Blacksheep909/Juno-1-FPV-Frame/README.md

<h1 align="center">Juno-1</h1>

<p align="center">
  <strong>A one-piece, 3D-printed 2.5" FPV quad frame I designed, analysed and refined before the first print.</strong><br>
  Sculpted tube structure, pusher props, battery underneath, and the stress, vibration and clearance analysis that shaped it.
</p>

<p align="center">
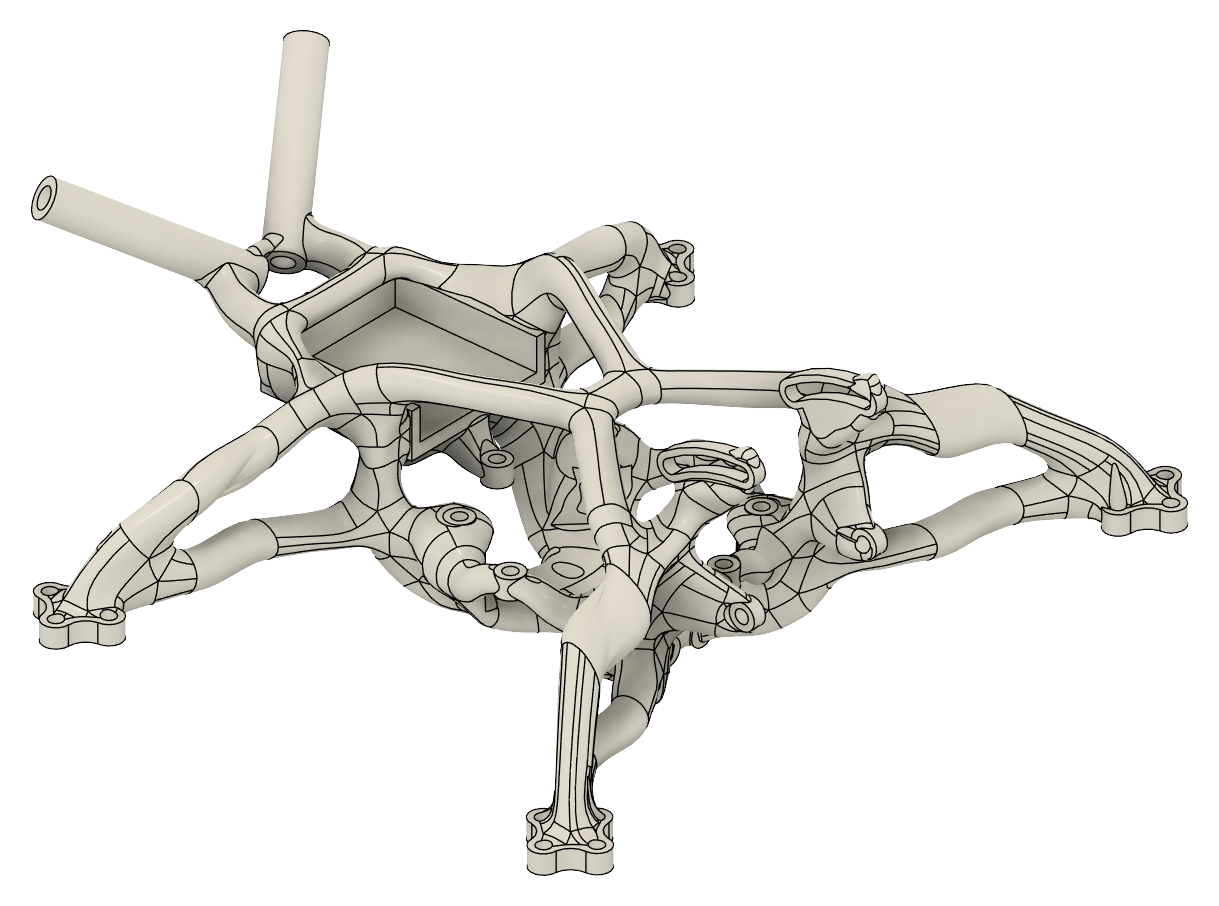
[picture p1: docs/images/cad-hero-iso.png]
Juno-1 Wide frame CAD render: a sculpted one-piece quad frame with twin-strut arms, an X-braced stack cage, a front camera mount and two rear antenna tubes
  
</p>

<p align="center">
  <a href="#the-frame">The frame</a> ·
  <a href="#what-i-designed-and-analysed">What I did</a> ·
  <a href="fea/README.md">FEA write-up</a> ·
  <a href="docs/design-notes.md">Design notes</a> ·
  <a href="stl"><strong>Download the STLs</strong></a>
</p>

<table>
  <tr>
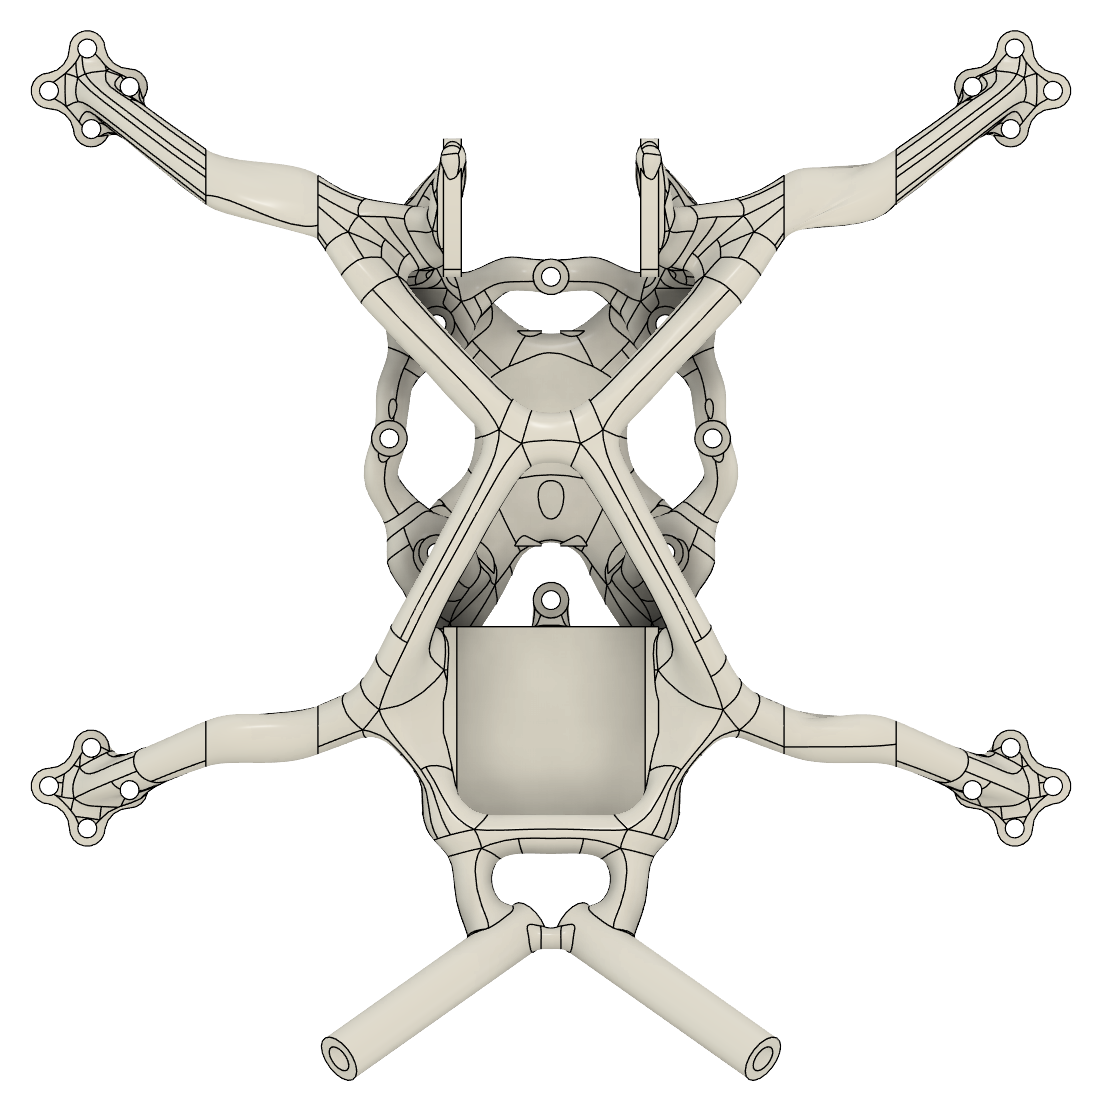
[picture p2: docs/images/cad-top.png]
Juno-1 Wide from above
    <td width="33%"><br><sub><b>Top.</b> X-braced stack cage, camera at the front, antenna tubes at the rear.</sub></td>
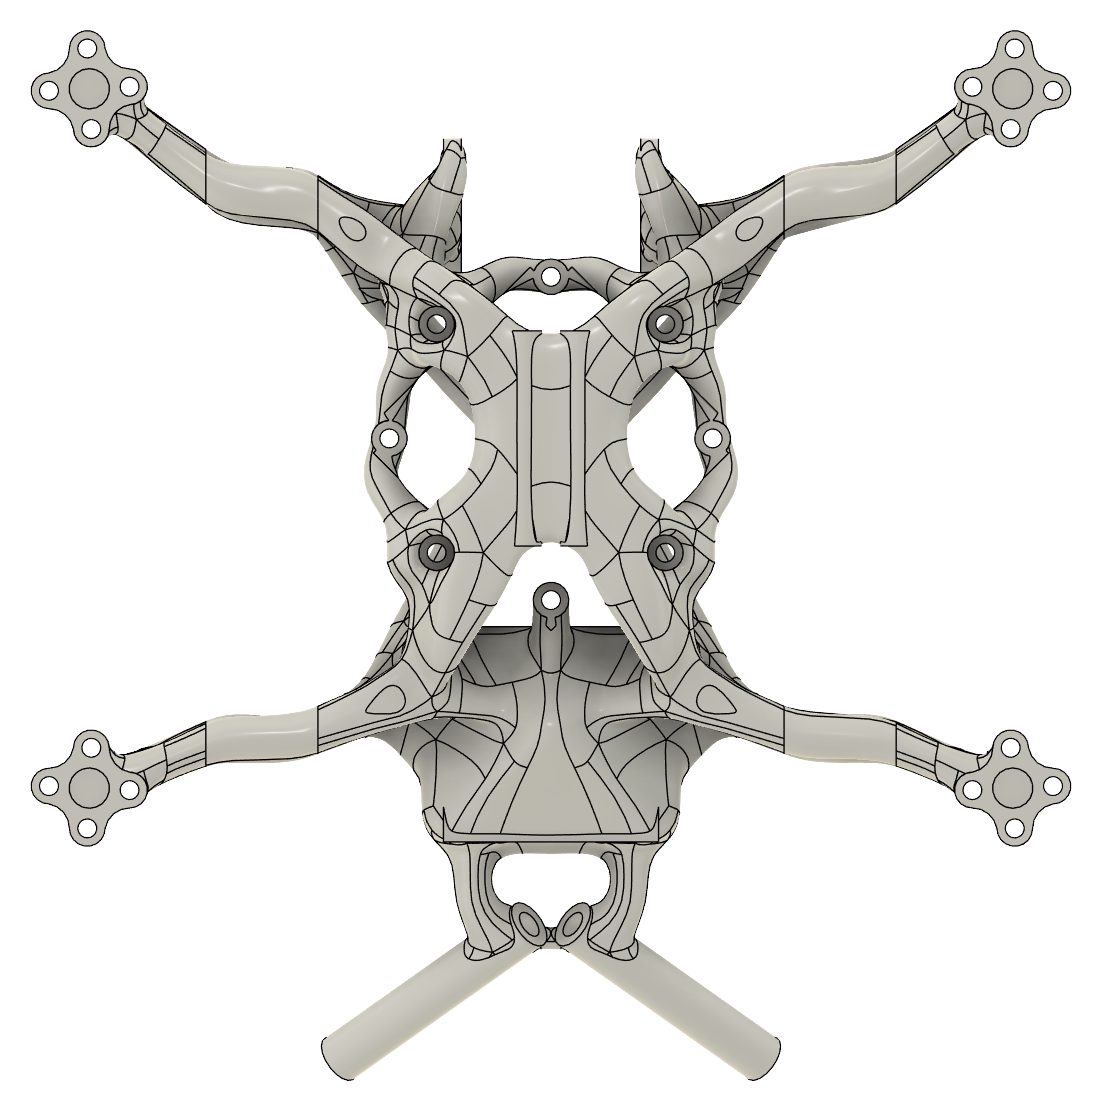
[picture p3: docs/images/cad-bottom.png]
Juno-1 Wide from below showing the battery rails
    <td width="33%"><br><sub><b>Bottom.</b> Battery rails and strap windows; motors bolt under the pads.</sub></td>
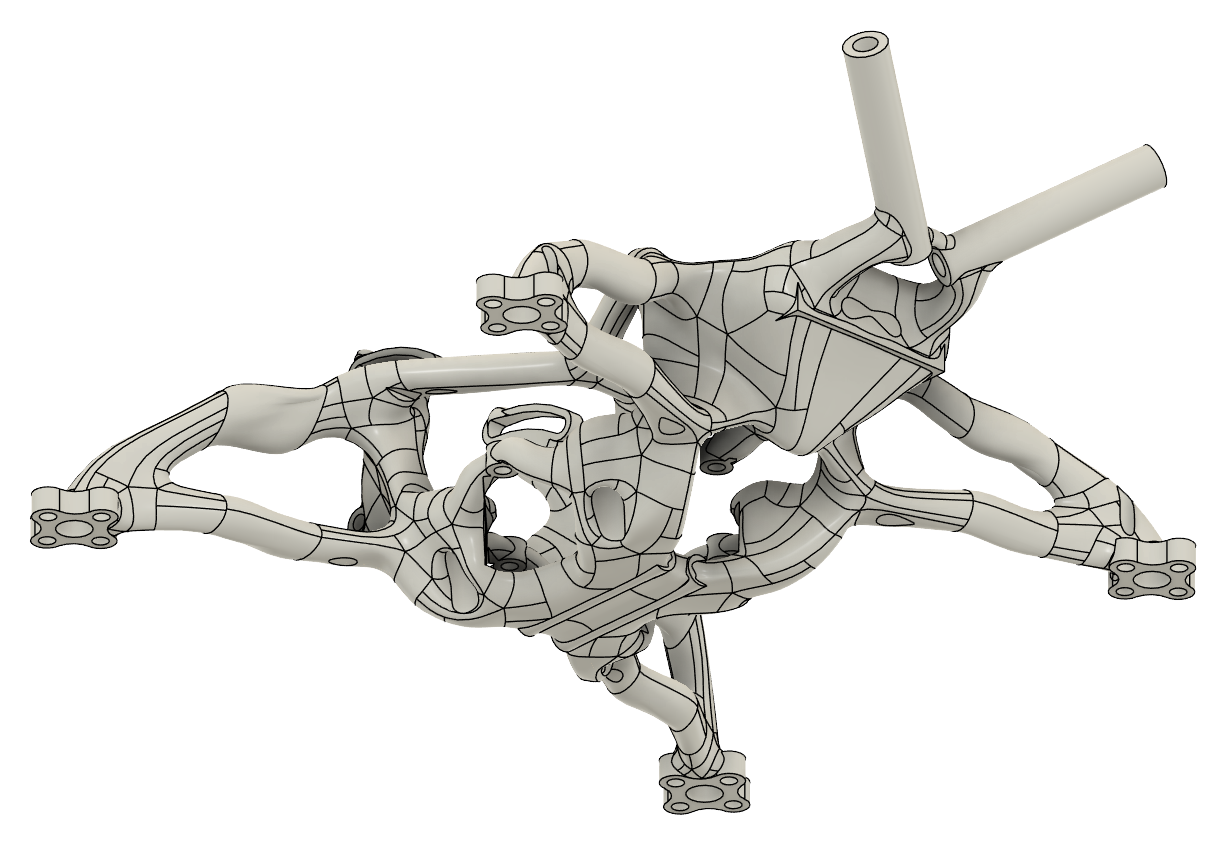
[picture p4: docs/images/cad-rear-iso-below.png]
Juno-1 Wide from the rear and below
    <td width="33%"><br><sub><b>Rear, from below.</b> Twin-strut arms meeting at each motor pad.</sub></td>
  </tr>
</table>

## The frame

Juno-1 is a 2.5" quad frame printed in one piece in PETG. Instead of flat carbon plates, the body and arms are a sculpted tube structure: each arm is a pair of struts that meet at the motor pad, the stack sits in an X-braced cage, the camera hangs off the front and two antenna tubes point back and up. It flies as a **pusher**, with the motors under the pads and the battery strapped under the belly.

This is the first build: the frame is designed, analysed and being printed now. Build photos and flight notes are coming.

| | |
| --- | --- |
| **Size** | 2.5" props, 129 mm wheelbase, 117 × 116 × 44.5 mm overall |
| **Layout** | Pusher: motors and props under the pads |
| **Battery** | 4S, strapped underneath, lying front to back (built around GNB 650 and 850 mAh packs) |
| **Motor mount** | 9 mm M2 pattern, Ø4.5 mm shaft pocket, two screws per motor |
| **Stack** | 25.5 × 25.5 mm whoop-style AIO |
| **Camera** | 19 mm micro camera |
| **Material** | PETG, 4 walls, 20% infill, printed in one piece |
| **CAD** | Fusion, with STEP, F3D and STL files included |

## What I designed and analysed

<p align="center">
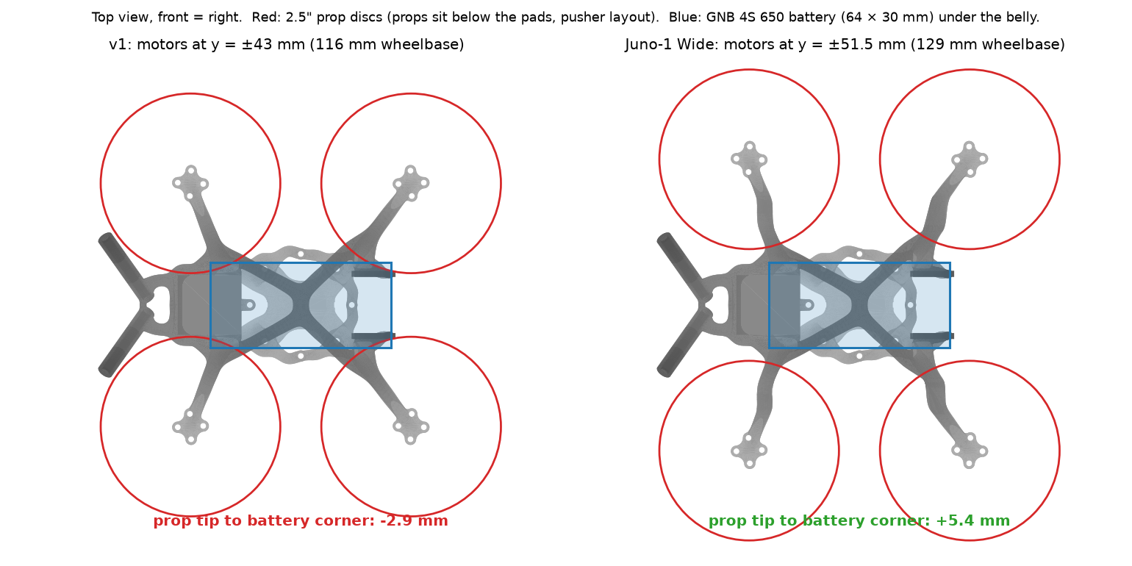
[picture p5: docs/images/layout-v1-vs-wide.png]
Top views of v1 and Juno-1 Wide with prop discs and battery footprint drawn: on v1 the props overlap the battery corners by 2.9 mm, on Juno-1 Wide they clear by 5.4 mm
  
</p>

- **Mechanical design.** A sculpted single-piece frame in Fusion, with twin-strut arms, an X-braced stack cage and built-in camera and antenna mounts. See the [design notes](docs/design-notes.md).
- **Analysis before printing.** I ran the first version (v1) through whole-frame finite-element stress analysis in PETG, with a separate check for stress across the print layers, plus free-free vibration analysis, printability checks and prop and battery clearance checks. See the [FEA write-up](fea/README.md).
- **Design changes driven by the analysis.**
  - In a pusher layout, v1's props reached 3 mm into a bottom-mounted 4S battery, so I moved the motors out to a 129 mm wheelbase. I did it by cutting the arms, moving the outer sections and lofting the eight struts back together with tangent ends.
  - A leftover prop-relief cut had left a sharp 90° notch under every arm root. I removed it.
  - Buried inboard screw holes led to a two-screw motor mount, which suits a pusher layout.
- **Open, reproducible tooling.** The FEA pipeline is plain Python (gmsh, scikit-fem, pyamg), so anyone can re-run it on their own revision. See [re-running](fea/README.md#re-running).

<table>
  <tr>
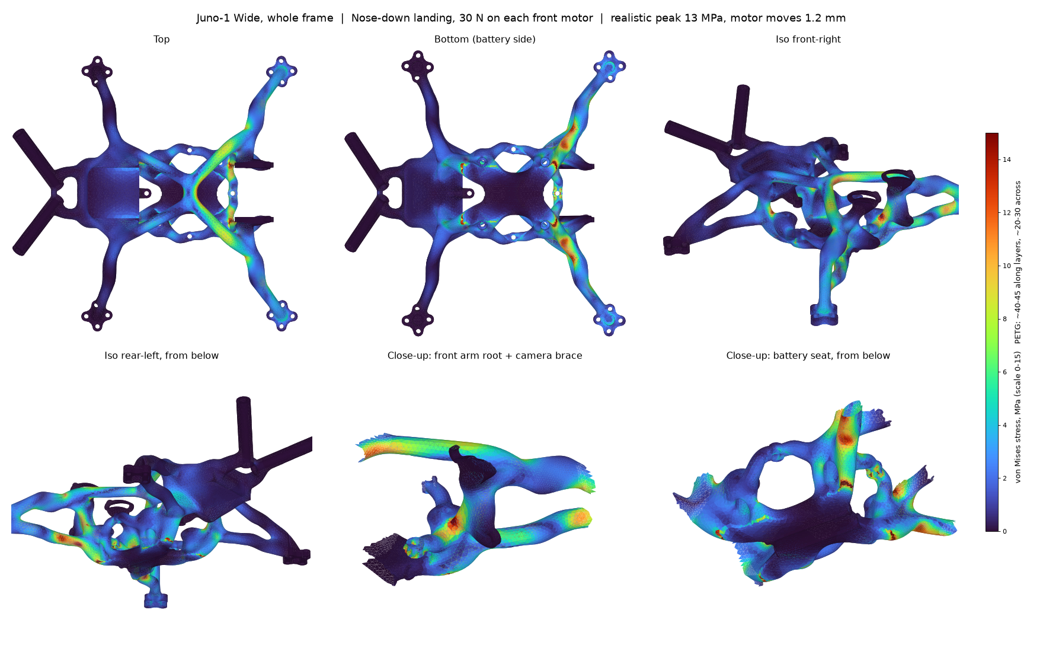
[picture p6: fea/results/images/nose_down.png]
Stress map of the nose-down landing case: the front arms and battery seat corners carry the load
    <td width="50%"><br><sub><b>Worst case: nose-down landing.</b> 30 N on each front motor; about 13 MPa realistic peak, a safety factor of about 3 in-layer.</sub></td>
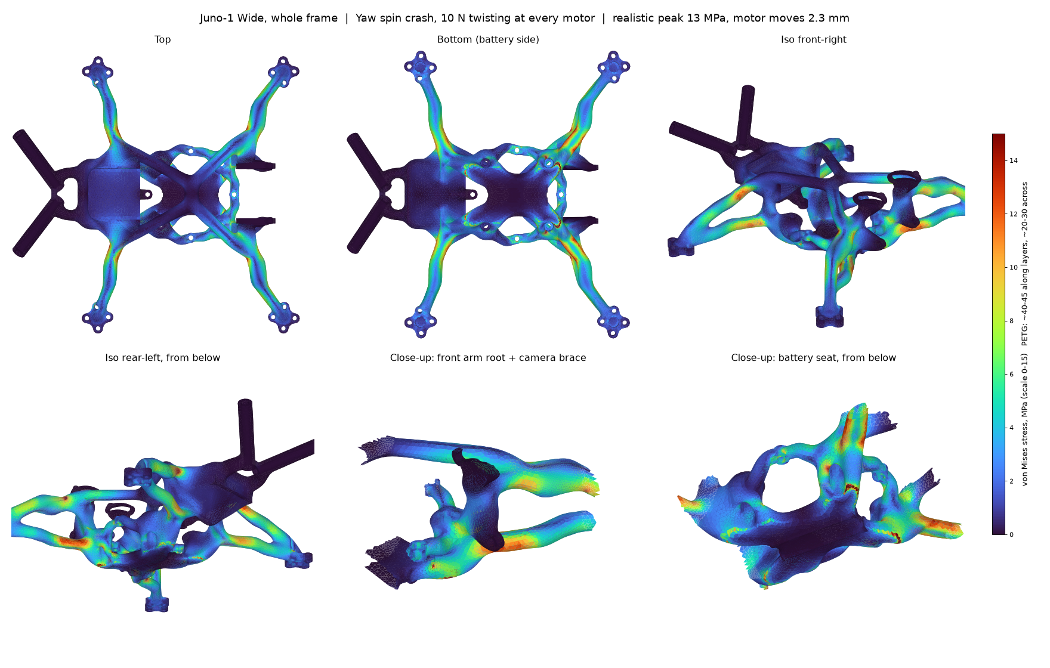
[picture p7: fea/results/images/yaw_spin.png]
Stress map of the yaw spin crash case: all four arms bending in-plane
    <td width="50%"><br><sub><b>Yaw spin crash.</b> All four arms bend in-plane; the front arms work hardest.</sub></td>
  </tr>
</table>

| Whole-frame load case | Realistic peak | SF in-layer | SF across layers |
| --- | --- | --- | --- |
| Full throttle | 1.5 MPa | 27 | 22 |
| Flat drop, 20 N per motor | 7.7 MPa | 5.2 | 4.3 |
| Nose-down landing, 30 N per front motor | 12.7 MPa | 3.1 | 2.3 |
| Yaw spin crash | 12.8 MPa | 3.1 | 3.5 |

## What this project demonstrates

Organic and sculpted CAD in Fusion, design for FDM printing, finite-element stress and vibration analysis with my own open-source pipeline, using analysis to drive real design changes (layout, clearances and stress risers), and documenting a hardware project so others can build on it.

## Get started

1. Download the Juno-2 frame in two parts, [`stl/Juno-2-Wide-frame-part-1.stl`](stl/Juno-2-Wide-frame-part-1.stl) and [`stl/Juno-2-Wide-frame-part-2.stl`](stl/Juno-2-Wide-frame-part-2.stl), and follow the [print guide](docs/print-guide.md).
2. Build it with the [build guide](docs/build-guide.md). It covers the two-screw motor mount, battery orientation and flight-controller setup.
3. To modify it, start from [`cad/Juno-2-Wide.f3d`](cad/Juno-2-Wide.f3d) (Fusion, editable timeline) or [`cad/Juno-2-Wide.step`](cad/Juno-2-Wide.step), then re-run the [FEA scripts](fea/README.md#re-running) on your version.

## Documentation

| | |
| --- | --- |
| [Design notes](docs/design-notes.md) | How v1 became Juno-1 Wide: what the checks found and what changed |
| [FEA write-up](fea/README.md) | Stress, vibration and print checks, method, limitations and how to re-run |
| [Print guide](docs/print-guide.md) | Slicer settings, supports and known print details |
| [Build guide](docs/build-guide.md) | Layout, parts, motor mounting, battery and flight setup |
| [CAD files](cad/README.md) | STEP and Fusion files for the current frame and v1 |

## License

Released under the [MIT License](LICENSE). Use it, print it, change it.

## Related work

The FEA approach builds on the stress analysis I did for the knee bracket of [Domino](https://github.com/Blacksheep909/Domino-ESP32-Quadruped), my ESP32 robot dog.
