Blacksheep909/Juno-1-FPV-Frame/docs/images/cad-front.png

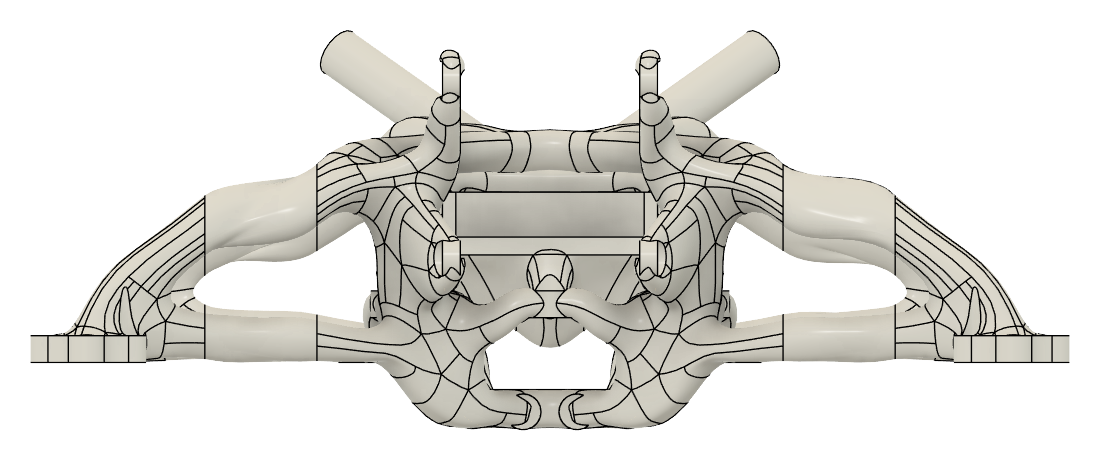
docs/images/cad-front.png
