Blacksheep909/Juno-1-FPV-Frame/cad/Juno-2-Wide.step

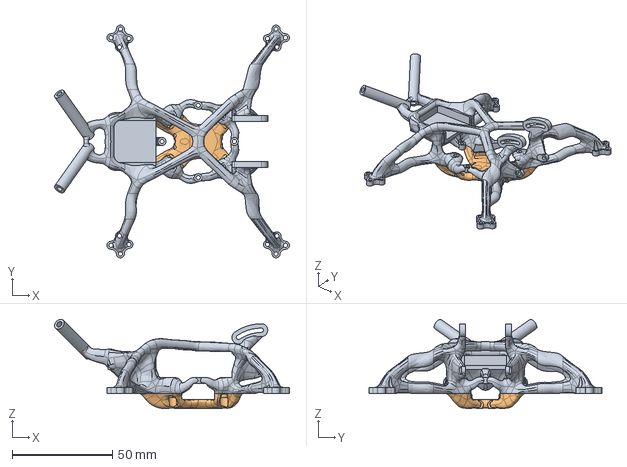
[picture p14: CAD file, 2026-10-25]
cad/Juno-2-Wide.step
117.1 x 116.0 x 44.5 mm
