Blacksheep909/Juno-1-FPV-Frame/stl/Juno-2-Wide-frame-part-1.stl

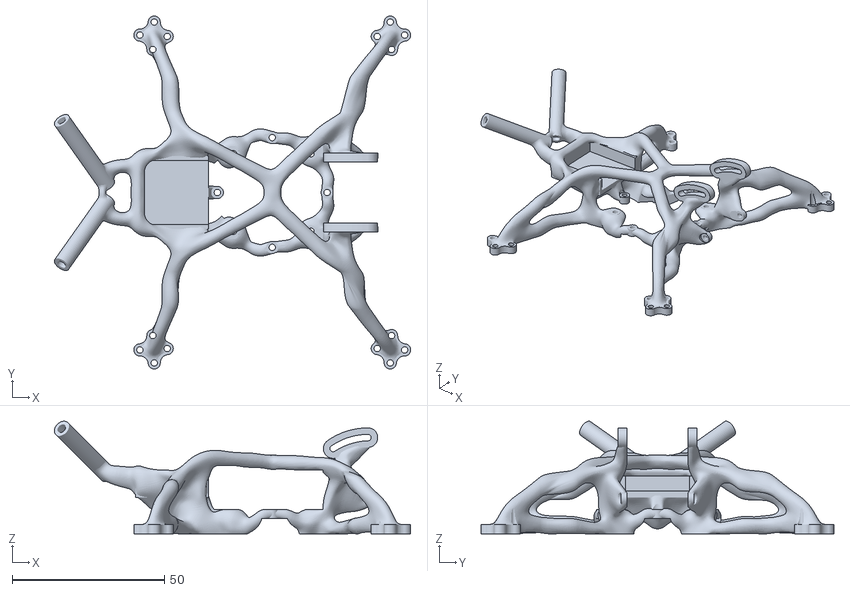
[picture p15: CAD file, 2026-10-26]
stl/Juno-2-Wide-frame-part-1.stl
117.1 x 116.0 x 37.0
