Blacksheep909/Juno-1-FPV-Frame/stl/Juno-2-Wide-frame-part-2.stl

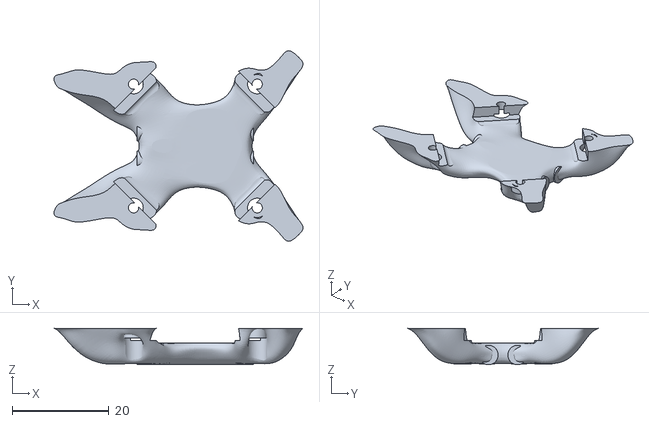
[picture p16: CAD file, 2026-10-26]
stl/Juno-2-Wide-frame-part-2.stl
51.3 x 39.3 x 7.50
