Blacksheep909/Juno-1-FPV-Frame/(list of files, cad)

Other CAD files:
cad/Juno-2-Wide.f3d
