Blacksheep909/Juno-1-FPV-Frame/(commit log)

2026-10-24 Juno-1: one-piece 3D-printed 2.5" pusher FPV frame
    Frame CAD (STEP + Fusion F3D) for Juno-1 Wide and the superseded v1,
    print-ready STLs and test arms, design notes, print and build guides,
    and the FEA pipeline (gmsh + scikit-fem + pyamg) with whole-frame
    stress, vibration and printability/clearance results.
    [Juno-1-Wide-frame.stl, Juno-1-Wide-test-arm-front.stl, Juno-1-Wide-test-arm-rear.stl, Juno-1-Wide.f3d, Juno-1-Wide.step, Juno-1-v1-116mm.f3d, Juno-1-v1-116mm.step]
2026-10-25 Replace published CAD and STLs with Juno-2 Wide
    Frame is now two printable parts. Old Juno-1 STLs, test arms and CAD
    are removed from the tree (still in history); docs point at Juno-2 files.
    [Juno-1-Wide-frame.stl, Juno-1-Wide-test-arm-front.stl, Juno-1-Wide-test-arm-rear.stl, Juno-1-Wide.f3d, Juno-1-Wide.step, Juno-1-v1-116mm.f3d, Juno-1-v1-116mm.step, Juno-2-Wide-frame-part-1.stl]
2026-10-25 Juno-2: reinforce camera rails
    Thicken the ring around each camera screw slot by 1.2 mm and each rail
    from 2 to 3 mm, growing away from the camera. Camera-facing faces and
    slots are unchanged. Re-exported STLs, STEP and F3D.
    [Juno-2-Wide-frame-part-1.stl, Juno-2-Wide.f3d, Juno-2-Wide.step]
2026-10-25 Juno-2: remove artifact on camera rail tops
    The tip of the old rail lip poked ~0.06 mm through the reinforced rail
    top, leaving a small stray patch. Deleted those faces so the top is
    one smooth surface. Re-exported part 1 STL, STEP and F3D.
    [Juno-2-Wide-frame-part-1.stl, Juno-2-Wide.f3d, Juno-2-Wide.step]
2026-10-25 Juno-2: remove lumps on camera side of rails
    A leftover lump at the front of each camera slot stuck ~0.5 mm past
    the camera face into the camera gap. Deleted it (and a small sliver
    under each ring) so the camera faces are flat. Re-exported part 1 STL,
    STEP and F3D.
    [Juno-2-Wide-frame-part-1.stl, Juno-2-Wide.f3d, Juno-2-Wide.step]
2026-10-25 Juno-2: trim lumps on lower camera mount
    The strut blend into each lower camera bracket stuck ~0.7 mm past the
    camera face into the camera gap. Trimmed it flush with the bracket's
    inner face on both sides. Re-exported part 1 STL, STEP and F3D.
    [Juno-2-Wide-frame-part-1.stl, Juno-2-Wide.f3d, Juno-2-Wide.step]
2026-10-25 Juno-2: thicken side arms around strap bosses
    Thicken both side tubes between the strap bosses and corner nodes by
    0.5 mm. Added before the AIO pocket cuts in the timeline, so the pocket,
    its sharp slide-in corners and the USB notch are unchanged. Includes the
    AIO pocket cuts. Re-exported part 1 STL, STEP and F3D.
    [Juno-2-Wide-frame-part-1.stl, Juno-2-Wide-frame-part-2.stl, Juno-2-Wide.f3d, Juno-2-Wide.step]
2026-10-25 Remove files added to the repo by mistake
    [Juno-2-Wide-frame-part-1.stl, Juno-2-Wide-frame-part-2.stl]
2026-10-25 Juno-2: revert side arm thickening
    The shell-based thickening left 0.5 mm steps where the arms meet the
    bosses and nodes. Removed it; arms are back to the previous shape with
    the AIO pocket cuts kept. Re-exported part 1 STL, STEP and F3D.
    [Juno-2-Wide-frame-part-1.stl, Juno-2-Wide.f3d, Juno-2-Wide.step]
2026-10-25 Juno-2: roll files back to the camera-mount fixes
    Restore the CAD and STLs from 31c1f88. The AIO pocket cuts haven't been
    print-tested yet, so they stay out of the published files until they have.
    [Juno-2-Wide-frame-part-1.stl, Juno-2-Wide.f3d, Juno-2-Wide.step]
2026-10-26 Update Juno-2 STLs
    [Juno-2-Wide-frame-part-1.stl, Juno-2-Wide-frame-part-2.stl]
